zephyrhasib/htm-tangible-banking/assets/tap_icons_sheet.pdf

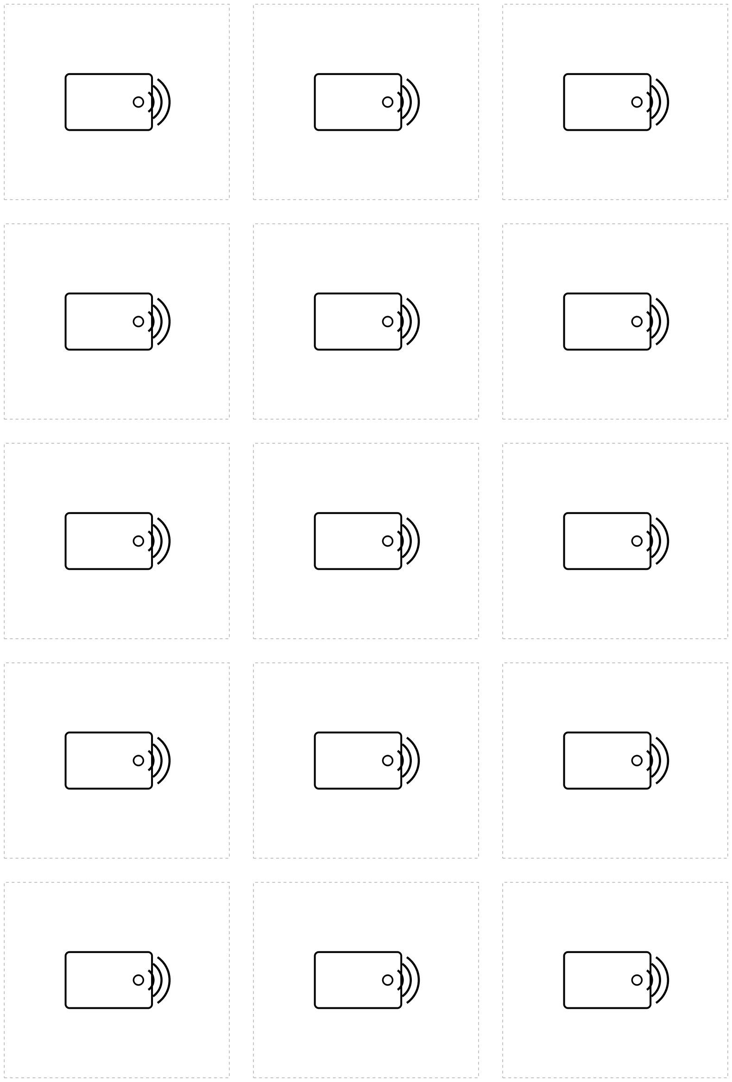
[picture p5: page 1]
