zephyrhasib/htm-tangible-banking/docs/images/dashboard-holding.jpg

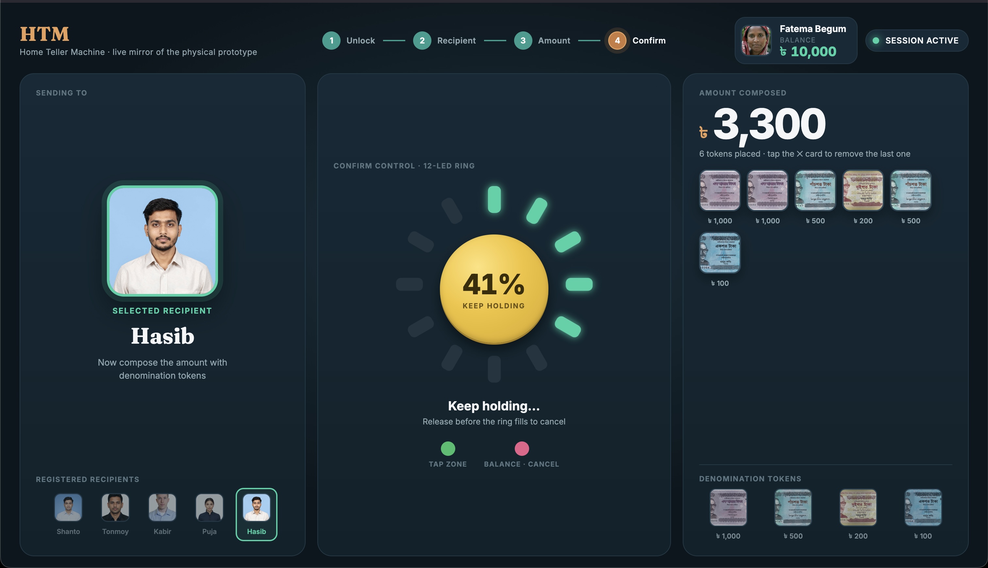
docs/images/dashboard-holding.jpg
