zephyrhasib/htm-tangible-banking/docs/images/dashboard-success.jpg

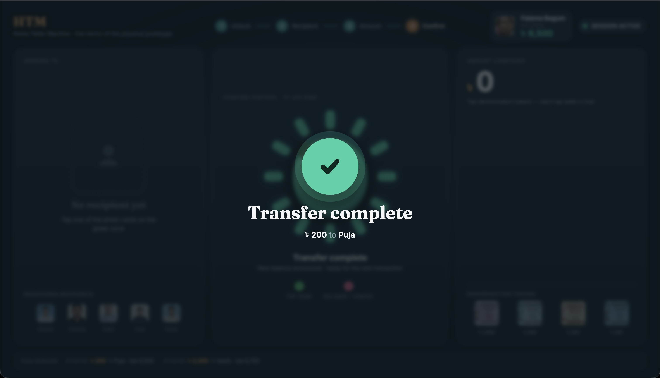
docs/images/dashboard-success.jpg
