zephyrhasib/htm-tangible-banking/(commit log)

2026-09-17 Add ESP32 firmware: state machine, RFID, audio, LED ring, serial telemetry
2026-09-17 Add audio pipeline: Bangla TTS generator, SFX synthesiser, track map
2026-09-17 Add printable token icons and tap-zone markers
